mokomull/smd-challenge/smd-challenge.kicad_pcb

## KiCad design smd-challenge.kicad_pcb (2021-03-25)

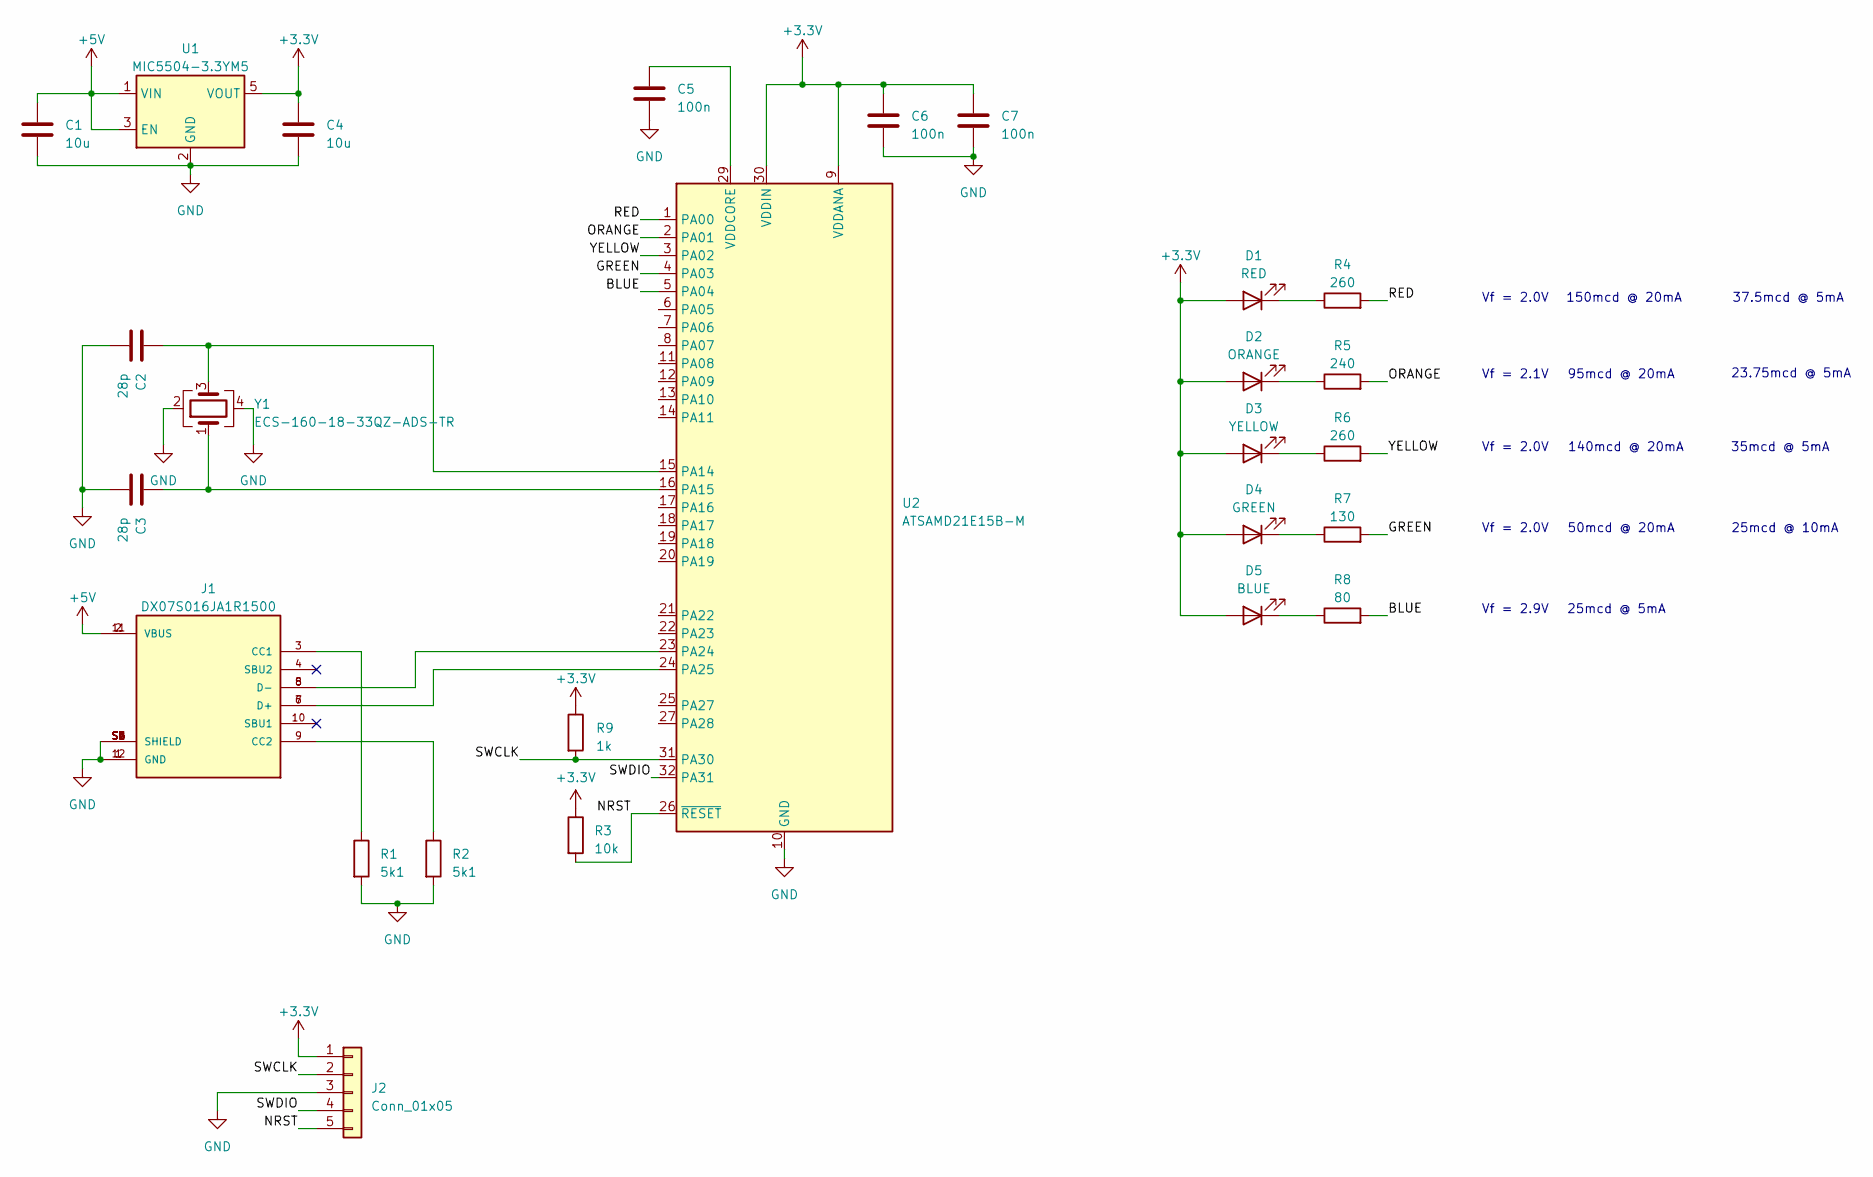
[picture p2: schematic smd-challenge.kicad_sch]

Parts:
C1, C4: 10u; C_1206_3216Metric; Digikey 1276-3100-1-ND
C2, C3: 28p; C_0603_1608Metric; Digikey 1276-1254-1-ND
C5, C6, C7: 100n; C_0603_1608Metric; Digikey 1276-1006-1-ND
D1: RED; LED_1206_3216Metric; Digikey 732-4991-1-ND
D2: ORANGE; LED_0805_2012Metric; Digikey 350-4355-1-ND
D3: YELLOW; LED_0603_1608Metric; Digikey 350-2032-1-ND
D4: GREEN; LED_0402_1005Metric; Digikey 732-11992-1-ND
D5: BLUE; LED_0201_0603Metric; Digikey 754-2022-1-ND
J1: DX07S016JA1R1500; JAE_DX07S016JA1R1500; PARTREV 1
J2: Conn_01x05; PinHeader_1x05_P2.54mm_Vertical_SMD_Pin1Left
R1, R2: 5k1; R_0603_1608Metric
R3: 10k; R_0603_1608Metric
R4: 260; R_1206_3216Metric; Digikey RMCF1206JT270RCT-ND
R5: 240; R_0805_2012Metric; Digikey RMCF0805JT240RCT-ND
R6: 260; R_0603_1608Metric; Digikey ‎RMCF0603JT270RCT-ND‎
R7: 130; R_0402_1005Metric; Digikey RMCF0402JT130RCT-ND
R8: 80; R_0201_0603Metric; Digikey P80.6ABCT-ND
R9: 1k; R_0603_1608Metric
U1: MIC5504-3.3YM5; SOT-23-5
U2: ATSAMD21E15B-M; QFN-32-1EP_5x5mm_P0.5mm_EP3.6x3.6mm
Y1: ECS-160-18-33QZ-ADS-TR; Crystal_SMD_SeikoEpson_FA238-4Pin_3.2x2.5mm

Connections:
+3V3: C4.1, C6.1, C7.1, D1.2 (A), D2.2 (A), D3.2 (A), D4.2 (A), D5.2 (A), J2.1, R3.1, R9.1, U1.5 (VOUT), U2.9 (VDDANA), U2.30 (VDDIN)
+5V: C1.1, J1.2 (VBUS), J1.11 (VBUS), U1.1 (VIN), U1.3 (EN)
/BLUE: R8.2, U2.5 (PA04)
/GREEN: R7.2, U2.4 (PA03)
/NRST: J2.5, R3.2, U2.26 (~RESET)
/ORANGE: R5.2, U2.2 (PA01)
/RED: R4.2, U2.1 (PA00)
/SWCLK: J2.2, R9.2, U2.31 (PA30)
/SWDIO: J2.4, U2.32 (PA31)
/YELLOW: R6.2, U2.3 (PA02)
GND: C1.2, C2.2, C3.2, C4.2, C5.2, C6.2, C7.2, J1.1 (GND), J1.12 (GND), J1.S1 (SHIELD), J1.S2 (SHIELD), J1.S3 (SHIELD), J1.S4 (SHIELD), J1.S5 (SHIELD), J1.S6 (SHIELD), J2.3, R1.2, R2.2, U1.2 (GND), U2.10 (GND), U2.28 (GND), Y1.2, Y1.4
unnamed: C2.1, U2.15 (PA14), Y1.3
unnamed: C3.1, U2.16 (PA15), Y1.1
unnamed: C5.1, U2.29 (VDDCORE)
unnamed: D1.1 (K), R4.1
unnamed: D2.1 (K), R5.1
unnamed: D3.1 (K), R6.1
unnamed: D4.1 (K), R7.1
unnamed: D5.1 (K), R8.1
unnamed: J1.3 (CC1), R1.1
unnamed: J1.5 (D-), J1.8 (D-), U2.23 (PA24)
unnamed: J1.6 (D+), J1.7 (D+), U2.24 (PA25)
unnamed: J1.9 (CC2), R2.1

Notes on the sheet:
Vf = 2.0V
Vf = 2.1V
Vf = 2.9V
25mcd @ 5mA
95mcd @ 20mA
50mcd @ 20mA
150mcd @ 20mA
140mcd @ 20mA
35mcd @ 5mA
25mcd @ 10mA
37.5mcd @ 5mA
23.75mcd @ 5mA

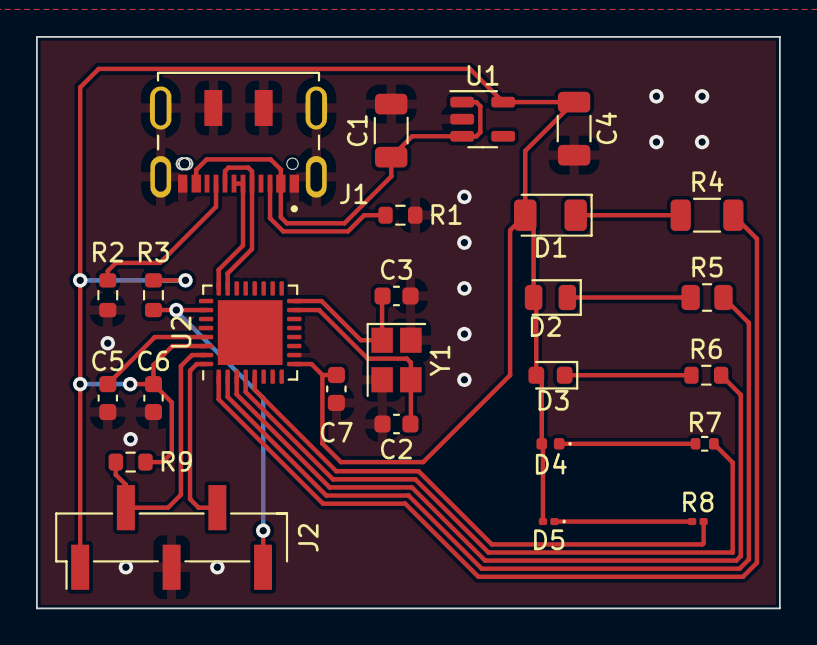
[picture p3: board smd-challenge.kicad_pcb from above]

Board: 2 copper layers, 41.3 x 31.8 mm, 26 parts (0 on the bottom side), 23 nets.
