mokomull/smd-challenge/(commit log)

2021-03-19 Start of a design.
    [DX07S016JA1R1500.step, smd-challenge.kicad_pcb, smd-challenge.kicad_sch]
2021-03-19 Swap crystal for something smaller; settle on layout
    [smd-challenge.kicad_pcb, smd-challenge.kicad_sch]
2021-03-19 Layout with the SAMD21.
    The only thing I really don't like is the snakey 3.3V rail but since I
    can stitch the grounds back together via the B.Cu zone, it's mostly
    fine.
    [smd-challenge.kicad_pcb, smd-challenge.kicad_sch]
2021-03-22 Pick parts for LEDs, values for resistors
    [smd-challenge.kicad_sch]
2021-03-22 Pick Digikey part numbers for more things
    [smd-challenge.kicad_sch]
2021-03-22 PCB: swap through-hole for SMD header
    [smd-challenge.kicad_pcb, smd-challenge.kicad_sch]
2021-03-22 PCB: nudge one trace over for better GND connectivity
    [smd-challenge.kicad_pcb]
2021-03-24 Add pull-up resistor on SWCLK per Microchip docs
    [smd-challenge.kicad_pcb, smd-challenge.kicad_sch]
2021-03-25 Nudge the USB connector closer to the edge of the board so it's possible to plug in, and adjust some traces for symmetry
    [smd-challenge.kicad_pcb]
2021-03-25 Add text to the back layer.
    [smd-challenge.kicad_pcb]
2021-03-25 Label the LEDs by color
    [smd-challenge.kicad_sch]
2021-03-25 Swap crystal (and load caps) for what's in stock at Mouser
    [smd-challenge.kicad_sch]
2021-03-25 /NRST should be connected to a pull-UP
    [smd-challenge.kicad_pcb, smd-challenge.kicad_sch]
2021-05-04 Fabrication output from initial run
    This was built at Aisler and populated with parts from Mouser.
    [bom.csv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]
2021-05-04 firmware: blink the red LED
    This actually loads onto the target device with the Black Magic firmware
    and runs fine!
2021-05-04 firmware: flash all the LEDs
    Not sure what makes my brain hurt more:
    (a) all this &mut dyn indirection, or
    (b) staring straight into the LEDs themselves
2021-05-06 fw: enable XOSC unconditionally
    This gets a nice 16MHz sine wave, probed at C2 and C3.
    "ondemand" was a surprise; the chip tries to be smart and enables the
    oscillator only when selected as a source for a GCLK, but I'm not quite
    ready for that yet.
    [main.rs]
2021-05-06 fw: try to enable TCC2
    It does not work, at all. COUNT is always reading out as zeroes.
    [main.rs]
2021-05-06 fw: use OSC8M to clock the timer
    This is the clock we get by default when we use with_internal_8mhz(),
    and DFLL48M is disabled by default.
    This outputs a 997Hz, 50% duty cycle square wave on the red LED.
2021-05-06 fw: use XOSC as the timer clock source
    This is a 16MHz crystal, so with /2 division it'll work exactly as
    before.
    This resulted in "1.00000kHz" as reported by the SDS 1104X-E, which is
    absolutely more precise than I expected it to be.
2021-05-06 fw: invert polarity, reduce brightness
    Idling the pin high means the LED idles *off*; this in turn means that
    "bigger number in the cc register means brighter".
    Even 50% duty cycle for this LED is way too bright, so turn that down a
    smidge.
    [main.rs]
2021-05-06 fw: generate 48MHz using the onboard FDPLL
    I intentionally left the CC register set low, because even
    2_000/48_000 = 4.1% duty cycle is plenty bright for this LED.
2021-05-08 fw: instantiate a USB device
    Once again, I built something that doesn't seem to work :(
    As far as I can tell, not even the D+ pull-up is enabled, and the host
    PC still doesn't know anything is connected to the port.
    (edit 3 days later: seems to have been a layer 1 problem, where the side
    of the MCU with D+ and D- pins didn't really get soldered down well. A
    bit of reflow and it's working fine now.)
    [main.rs]
2021-05-08 fw: first stab at USB HID
    This is detected as a USB HID device by Linux, but doesn't actually show
    up in /sys/class/leds at all.
    This results in a seemingly reasonable device/interface/report
    descriptor:
    Bus 001 Device 111: ID 1337:4209 Matt Mullins smd-challenge
    Device Descriptor:
    bLength 18
    bDescriptorType 1
    bcdUSB 2.10
    bDeviceClass 0
    bDeviceSubClass 0
    bDeviceProtocol 0
    bMaxPacketSize0 8
    idVendor 0x1337
    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
    [main.rs]
2021-05-08 fw: tweak USB HID descriptor a bit
    The Application collection needed to be a "Generic Desktop - Keyboard"
    usage (which is usage type "CA" in the HID Usage Tables).
    This results in:
    Report Descriptor: (length is 25)
    Item(Global): Usage Page, data= [ 0x01 ] 1
    Generic Desktop Controls
    Item(Local ): Usage, data= [ 0x06 ] 6
    Keyboard
    Item(Main ): Collection, data= [ 0x01 ] 1
    Application
    Item(Global): Usage Page, data= [ 0x08 ] 8
    LEDs
    Item(Local ): Usage, data= [ 0x01 ] 1
    NumLock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
2021-05-09 fw: make my own HID report descriptor
    The macro language doesn't seem to be flexible enough to define
    repetitive bitfields, so write it by hand. This seems to parse
    correctly, but still doesn't give me multiple LED objects in Linux.
    [main.rs]
2021-05-09 fw: use arbitrary LED IDs
    compose, kana, sleep, suspend, and mail all seem to default to the
    "none" trigger in Linux, and at least lets me distinguish them in
    /sys/class/leds. With wireshark, this seems to transmit the OUT reports
    I expect, too (i.e. compose is the least-significant bit, mail is the
    most-significant bit).
2021-05-09 fw: turn on orange LED via USB
    This is on the TCC2 timer as well, so it's pretty straightforward.
2021-05-09 fw: use GPIO for yellow, green, and blue
    TCC3 doesn't exist at all on the SAMD21E15B, so I don't have any PWM
    options for these three colors. So they're going to be crazy bright,
    but most importantly: THEY WORK!
    [main.rs]
2021-05-09 fw: use plain GPIO for all LEDs
    Since I don't have a timer that is usable for PWM on three of the five
    LEDs, use plain GPIO for all of them. This is incredibly bright, but
    it's consistent.
2021-05-09 Add udev rules that match the USB device.
    This actually works every time I plug the device in!
