mokomull/smd-challenge/(notices)

Notices in the files:
smd-challenge.kicad_pcb:
© 2021 Matt Mullins
